AnotherGio/PROYECTO_MINI_SUMO/README.md

# PROYECTO_MINI_SUMO
Diseño e implementación de un mini sumo usando el microcontrolador STM32F103C8
