AnotherGio/PROYECTO_MINI_SUMO/ESQUEMATICOS/Read_me.txt

Los siguientes esquematicos fueron realizados en el software
KiCAD, si se tiene algun problema de falta de librerias, por
favor contactar al siguiente correo: srgonzalez1997@gmail.com
