AnotherGio/PROYECTO_MINI_SUMO/INFORME/Read_me.txt

Se suben los dos archivos, para prevenir si la version de office
del usuario que la descargue no le es compatible o hace cambios que 
puedan afectar el entendimiento del documento.
