AnotherGio/PROYECTO_MINI_SUMO/DATA_SHEET/READ_ME.txt

En esta seccion del repositorio se anexan los datasheets
empleados en el diseño y la implementación del mini sumo bot.
