AnotherGio/PROYECTO_MINI_SUMO/PARTES_SUMO_FREECAD/Read_me.txt

En esta seccion se dejan los dos modelos que se hicieron 
para el mini sumo, por cuestiones de practicidad se hace 
el uso del modelo 2.
