AnotherGio/PROYECTO_MINI_SUMO/STL/Read_me.txt

En esta seccion puede encontrar los archivos que fueron exportados del FreeCAD
para poder imprimir cada una de las piezas del mini sumo.
