AnotherGio/PROYECTO_MINI_SUMO/STL/CHASIS_FINAL.stl

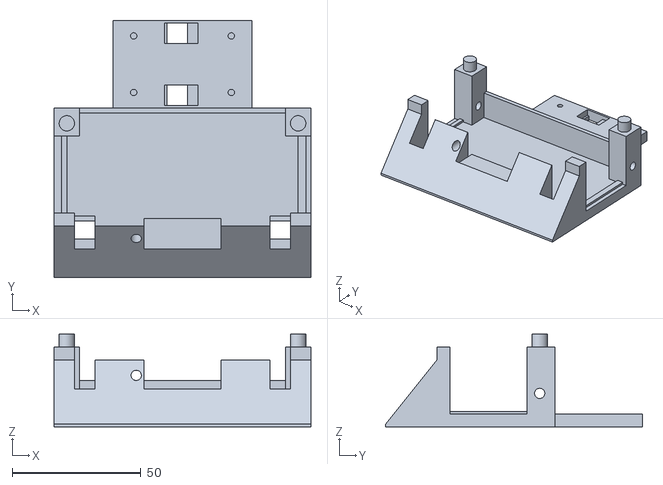
[picture p23: CAD file, 2019-05-18]
STL/CHASIS_FINAL.stl
100.0 x 100.0 x 36.0
