AnotherGio/PROYECTO_MINI_SUMO/STL/TAPA_PISO_2.stl

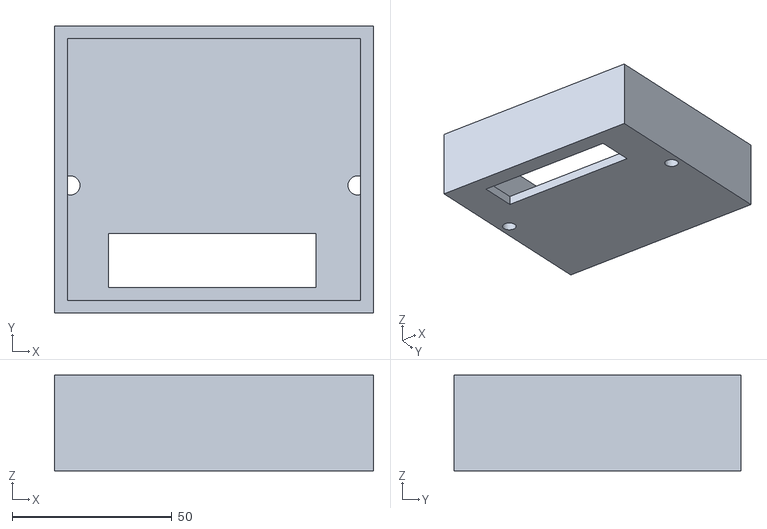
[picture p24: CAD file, 2019-05-18]
STL/TAPA_PISO_2.stl
100.0 x 90.0 x 30.0
